xmyoot/compact-bluetooth-wearable/analysis/README.md

# Current analysis files

Current evidence: `erc.rpt`, `drc.json`, `schematic.xml`, `pad-net-crosscheck.json/csv`, `geometry-summary.json`, `schematic.json`, `pcb.json`, `cross.json`, `emc.json`, `thermal.json`, `gerbers.json`, `bom.csv` and `lifecycle.json`. Read `../docs/design-review.md` for the verdict and triage; analyzer JSON is not a release approval.

`routing-candidates/` contains rejected/intermediate boards and logs. Older placement/routing reports at this level are historical, not final results. `reproduction/` contains construction provenance; the final native files are authoritative.
