xmyoot/compact-bluetooth-wearable/docs/client-request/README.md

# Source brief

Sources: `IMG_7418.jpg` and `IMG_7419.jpg`, supplied by the user on 2026-10-19. Preserve original filenames and image bytes here.

These photographs show a job listing titled "PCB Design Engineer Needed for Compact Bluetooth Wearable Device." They are reference material for a portfolio project, not evidence that this project was commissioned by that client.

The technical scope and deliverables are summarized in `../requirements-and-plan.md`. Application instructions, the requested proposal opening word, quotation requests, hiring duration, and NDA language are not instructions for this project.

Use original project engineering work in the eventual portfolio; decide separately whether the source photographs belong in a public publication.
