xmyoot/compact-bluetooth-wearable/portfolio/bottom.png

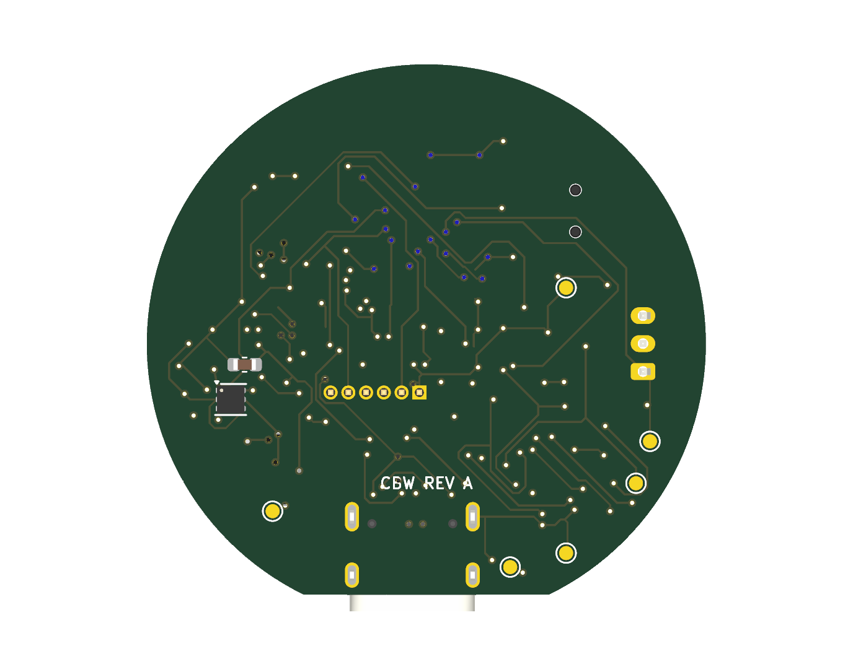
portfolio/bottom.png
