xmyoot/compact-bluetooth-wearable/portfolio/top.png

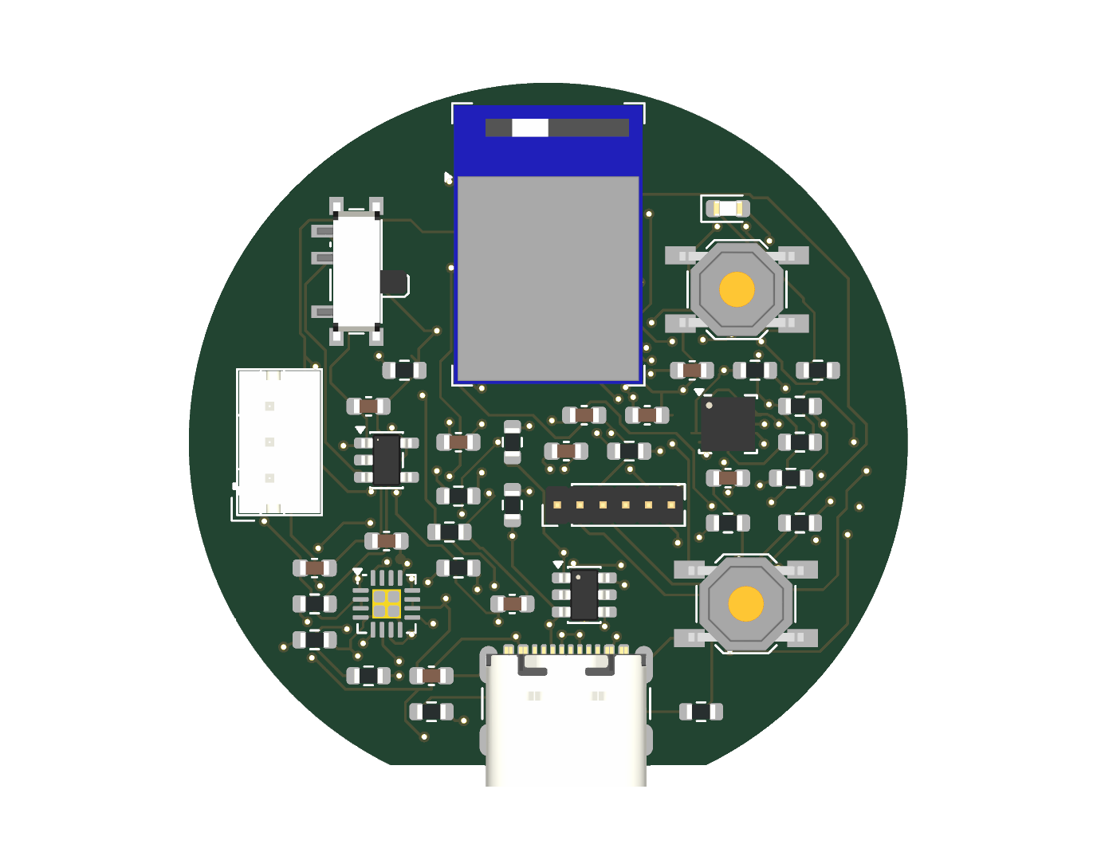
portfolio/top.png
