xmyoot/compact-bluetooth-wearable/analysis/pad-net-crosscheck.csv

Reference | Pad | Schematic net | PCB net | Result
D1 | 1 | LED_K | LED_K | match
D1 | 2 | +3V0 | +3V0 | match
J3 | 1 | +3V0 | +3V0 | match
J3 | 2 | SWDIO | SWDIO | match
J3 | 3 | SWCLK | SWCLK | match
J3 | 4 | GND | GND | match
J3 | 5 | RESET_N | RESET_N | match
J3 | 6 | GND | GND | match
SW3 | 1 | RESET_N | RESET_N | match
SW3 | 1 | RESET_N | RESET_N | match
SW3 | 2 | GND | GND | match
SW3 | 2 | GND | GND | match
R18 | 1 | BAT_SENSE | BAT_SENSE | match
R18 | 2 | GND | GND | match
C9 | 1 | +3V0 | +3V0 | match
C9 | 2 | GND | GND | match
R4 | 1 | USB_CONN_N | USB_CONN_N | match
R4 | 2 | USB_N | USB_N | match
R19 | 1 | ACC_SA0 | ACC_SA0 | match
R19 | 2 | GND | GND | match
C1 | 1 | +3V0 | +3V0 | match
C1 | 2 | GND | GND | match
J1 | A1 | GND | GND | match
J1 | A4 | VBUS | VBUS | match
J1 | A5 | CC1 | CC1 | match
J1 | A6 | USB_CONN_P | USB_CONN_P | match
J1 | A7 | USB_CONN_N | USB_CONN_N | match
J1 | A8 |  |  | match
J1 | A9 | VBUS | VBUS | match
J1 | A12 | GND | GND | match
J1 | B1 | GND | GND | match
J1 | B4 | VBUS | VBUS | match
J1 | B5 | CC2 | CC2 | match
J1 | B6 | USB_CONN_P | USB_CONN_P | match
J1 | B7 | USB_CONN_N | USB_CONN_N | match
J1 | B8 |  |  | match
J1 | B9 | VBUS | VBUS | match
J1 | B12 | GND | GND | match
J1 | SH | GND | GND | match
J1 | SH | GND | GND | match
J1 | SH | GND | GND | match
J1 | SH | GND | GND | match
C7 | 1 | VSYS | VSYS | match
C7 | 2 | GND | GND | match
U1 | 1 | GND | GND | match
U1 | 2 | GND | GND | match
U1 | 3 |  |  | match
U1 | 4 |  |  | match
U1 | 5 |  |  | match
U1 | 6 |  |  | match
U1 | 7 |  |  | match
U1 | 8 |  |  | match
U1 | 9 |  |  | match
U1 | 10 |  |  | match
U1 | 11 | BAT_SENSE | BAT_SENSE | match
U1 | 12 |  |  | match
U1 | 13 |  |  | match
U1 | 14 |  |  | match
U1 | 15 | GND | GND | match
U1 | 16 | I2C_SCL | I2C_SCL | match
U1 | 17 |  |  | match
U1 | 18 |  |  | match
U1 | 19 | I2C_SDA | I2C_SDA | match
U1 | 20 |  |  | match
U1 | 21 |  |  | match
U1 | 22 |  |  | match
U1 | 23 |  |  | match
U1 | 24 |  |  | match
U1 | 25 |  |  | match
U1 | 26 |  |  | match
U1 | 27 | ACC_INT | ACC_INT | match
U1 | 28 | +3V0 | +3V0 | match
U1 | 29 | TEMP_ALERT | TEMP_ALERT | match
U1 | 30 | +3V0 | +3V0 | match
U1 | 31 |  |  | match
U1 | 32 | VBUS | VBUS | match
U1 | 33 | GND | GND | match
U1 | 34 | USB_N | USB_N | match
U1 | 35 | USB_P | USB_P | match
U1 | 36 | LED_STATUS | LED_STATUS | match
U1 | 37 | USER_N | USER_N | match
U1 | 38 | CHG_EN1 | CHG_EN1 | match
U1 | 39 | CHG_EN2 | CHG_EN2 | match
U1 | 40 | RESET_N | RESET_N | match
U1 | 41 | CHARGE_N | CHARGE_N | match
U1 | 42 | PGOOD_N | PGOOD_N | match
U1 | 43 |  |  | match
U1 | 44 |  |  | match
U1 | 45 |  |  | match
U1 | 46 |  |  | match
U1 | 47 |  |  | match
U1 | 48 |  |  | match
U1 | 49 |  |  | match
U1 | 50 |  |  | match
U1 | 51 | SWDIO | SWDIO | match
U1 | 52 |  |  | match
U1 | 53 | SWCLK | SWCLK | match
U1 | 54 |  |  | match
U1 | 55 | GND | GND | match
U1 | 56 |  |  | match
U1 | 57 |  |  | match
U1 | 58 |  |  | match
U1 | 59 |  |  | match
U1 | 60 |  |  | match
U1 | 61 |  |  | match
R17 | 1 | VBAT | VBAT | match
R17 | 2 | BAT_SENSE | BAT_SENSE | match
R3 | 1 | USB_CONN_P | USB_CONN_P | match
R3 | 2 | USB_P | USB_P | match
R12 | 1 | I2C_SDA | I2C_SDA | match
R12 | 2 | +3V0 | +3V0 | match
J2 | 1 | VBAT | VBAT | match
J2 | 2 | BAT_NTC | BAT_NTC | match
J2 | 3 | GND | GND | match
R1 | 1 | CC1 | CC1 | match
R1 | 2 | GND | GND | match
R16 | 1 | LED_K | LED_K | match
R16 | 2 | LED_STATUS | LED_STATUS | match
R15 | 1 | RESET_N | RESET_N | match
R15 | 2 | +3V0 | +3V0 | match
R10 | 1 | CHARGE_N | CHARGE_N | match
R10 | 2 | +3V0 | +3V0 | match
C6 | 1 | VSYS | VSYS | match
C6 | 2 | GND | GND | match
D2 | 1 | USB_CONN_P | USB_CONN_P | match
D2 | 2 | GND | GND | match
D2 | 3 | USB_CONN_N | USB_CONN_N | match
D2 | 4 | USB_CONN_N | USB_CONN_N | match
D2 | 5 | VBUS | VBUS | match
D2 | 6 | USB_CONN_P | USB_CONN_P | match
R5 | 1 | ISET | ISET | match
R5 | 2 | GND | GND | match
R6 | 1 | ILIM | ILIM | match
R6 | 2 | GND | GND | match
R8 | 1 | CHG_EN2 | CHG_EN2 | match
R8 | 2 | GND | GND | match
C2 | 1 | +3V0 | +3V0 | match
C2 | 2 | GND | GND | match
R7 | 1 | CHG_EN1 | CHG_EN1 | match
R7 | 2 | GND | GND | match
U3 | 1 | VSYS | VSYS | match
U3 | 2 | GND | GND | match
U3 | 3 | POWER_EN | POWER_EN | match
U3 | 4 |  |  | match
U3 | 5 | +3V0 | +3V0 | match
U2 | 1 | BAT_NTC | BAT_NTC | match
U2 | 2 | VBAT | VBAT | match
U2 | 3 | VBAT | VBAT | match
U2 | 4 | GND | GND | match
U2 | 5 | CHG_EN2 | CHG_EN2 | match
U2 | 6 | CHG_EN1 | CHG_EN1 | match
U2 | 7 | PGOOD_N | PGOOD_N | match
U2 | 8 | GND | GND | match
U2 | 9 | CHARGE_N | CHARGE_N | match
U2 | 10 | VSYS | VSYS | match
U2 | 11 | VSYS | VSYS | match
U2 | 12 | ILIM | ILIM | match
U2 | 13 | VBUS | VBUS | match
U2 | 14 |  |  | match
U2 | 15 |  |  | match
U2 | 16 | ISET | ISET | match
U2 | 17 | GND | GND | match
C8 | 1 | +3V0 | +3V0 | match
C8 | 2 | GND | GND | match
R2 | 1 | CC2 | CC2 | match
R2 | 2 | GND | GND | match
U4 | 1 | +3V0 | +3V0 | match
U4 | 2 |  |  | match
U4 | 3 |  |  | match
U4 | 4 | I2C_SCL | I2C_SCL | match
U4 | 5 | GND | GND | match
U4 | 6 | I2C_SDA | I2C_SDA | match
U4 | 7 | ACC_SA0 | ACC_SA0 | match
U4 | 8 | +3V0 | +3V0 | match
U4 | 9 |  |  | match
U4 | 10 | GND | GND | match
U4 | 11 | ACC_INT | ACC_INT | match
U4 | 12 | GND | GND | match
U4 | 13 | GND | GND | match
U4 | 14 | +3V0 | +3V0 | match
U4 | 15 | GND | GND | match
U4 | 16 | GND | GND | match
C4 | 1 | VBUS | VBUS | match
C4 | 2 | GND | GND | match
R11 | 1 | I2C_SCL | I2C_SCL | match
R11 | 2 | +3V0 | +3V0 | match
SW1 | 1 | VSYS | VSYS | match
SW1 | 2 | POWER_EN | POWER_EN | match
SW1 | 3 | GND | GND | match
SW2 | 1 | USER_N | USER_N | match
SW2 | 1 | USER_N | USER_N | match
SW2 | 2 | GND | GND | match
SW2 | 2 | GND | GND | match
R14 | 1 | USER_N | USER_N | match
R14 | 2 | +3V0 | +3V0 | match
C5 | 1 | VBAT | VBAT | match
C5 | 2 | GND | GND | match
R13 | 1 | TEMP_ALERT | TEMP_ALERT | match
R13 | 2 | +3V0 | +3V0 | match
R9 | 1 | PGOOD_N | PGOOD_N | match
R9 | 2 | +3V0 | +3V0 | match
C3 | 1 | VBUS | VBUS | match
C3 | 2 | GND | GND | match
C10 | 1 | +3V0 | +3V0 | match
C10 | 2 | GND | GND | match
C12 | 1 | BAT_SENSE | BAT_SENSE | match
C12 | 2 | GND | GND | match
TP1 | 1 | GND | GND | match
TP2 | 1 | VBUS | VBUS | match
TP3 | 1 | VBAT | VBAT | match
C11 | 1 | +3V0 | +3V0 | match
C11 | 2 | GND | GND | match
TP6 | 1 | ACC_INT | ACC_INT | match
TP5 | 1 | +3V0 | +3V0 | match
U5 | 1 | I2C_SCL | I2C_SCL | match
U5 | 2 | GND | GND | match
U5 | 3 | TEMP_ALERT | TEMP_ALERT | match
U5 | 4 | GND | GND | match
U5 | 5 | +3V0 | +3V0 | match
U5 | 6 | I2C_SDA | I2C_SDA | match
U5 | 7 |  |  | match
TP4 | 1 | VSYS | VSYS | match
