xmyoot/compact-bluetooth-wearable/manufacturing/engineering-preview-NOT-FOR-FAB/board-preview.step

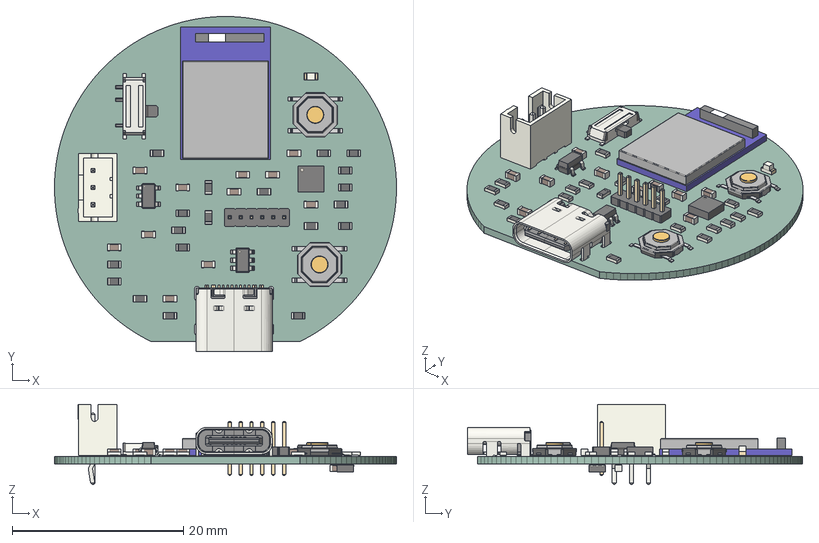
[picture p5: CAD file, 2026-10-21]
manufacturing/engineering-preview-NOT-FOR-FAB/board-preview.step
40.0 x 39.2 x 9.40 mm
LED_0603_1608Metric
PinHeader_1x06_P127mm_Vertical
SW_SPST_TL3342 x 2
R_0603_1608Metric x 19
C_0603_1608Metric x 12
USB_C_Receptacle_16P_TopMnt_Horizontal_GCT_USB4105-xx-A
Raytac_MDBT50Q
JST_B3B_PH_K
SOT-23-6
SOT-23-5
LGA_16_3x3mm_P05mm_LayoutBorder3x5y
Fusion_sp
WSON_6_1EP_2x2mm_P065mm_EP1x16mm
Compact-Bluetooth-Wearable_PCB
