xmyoot/compact-bluetooth-wearable/analysis/schematic.pdf

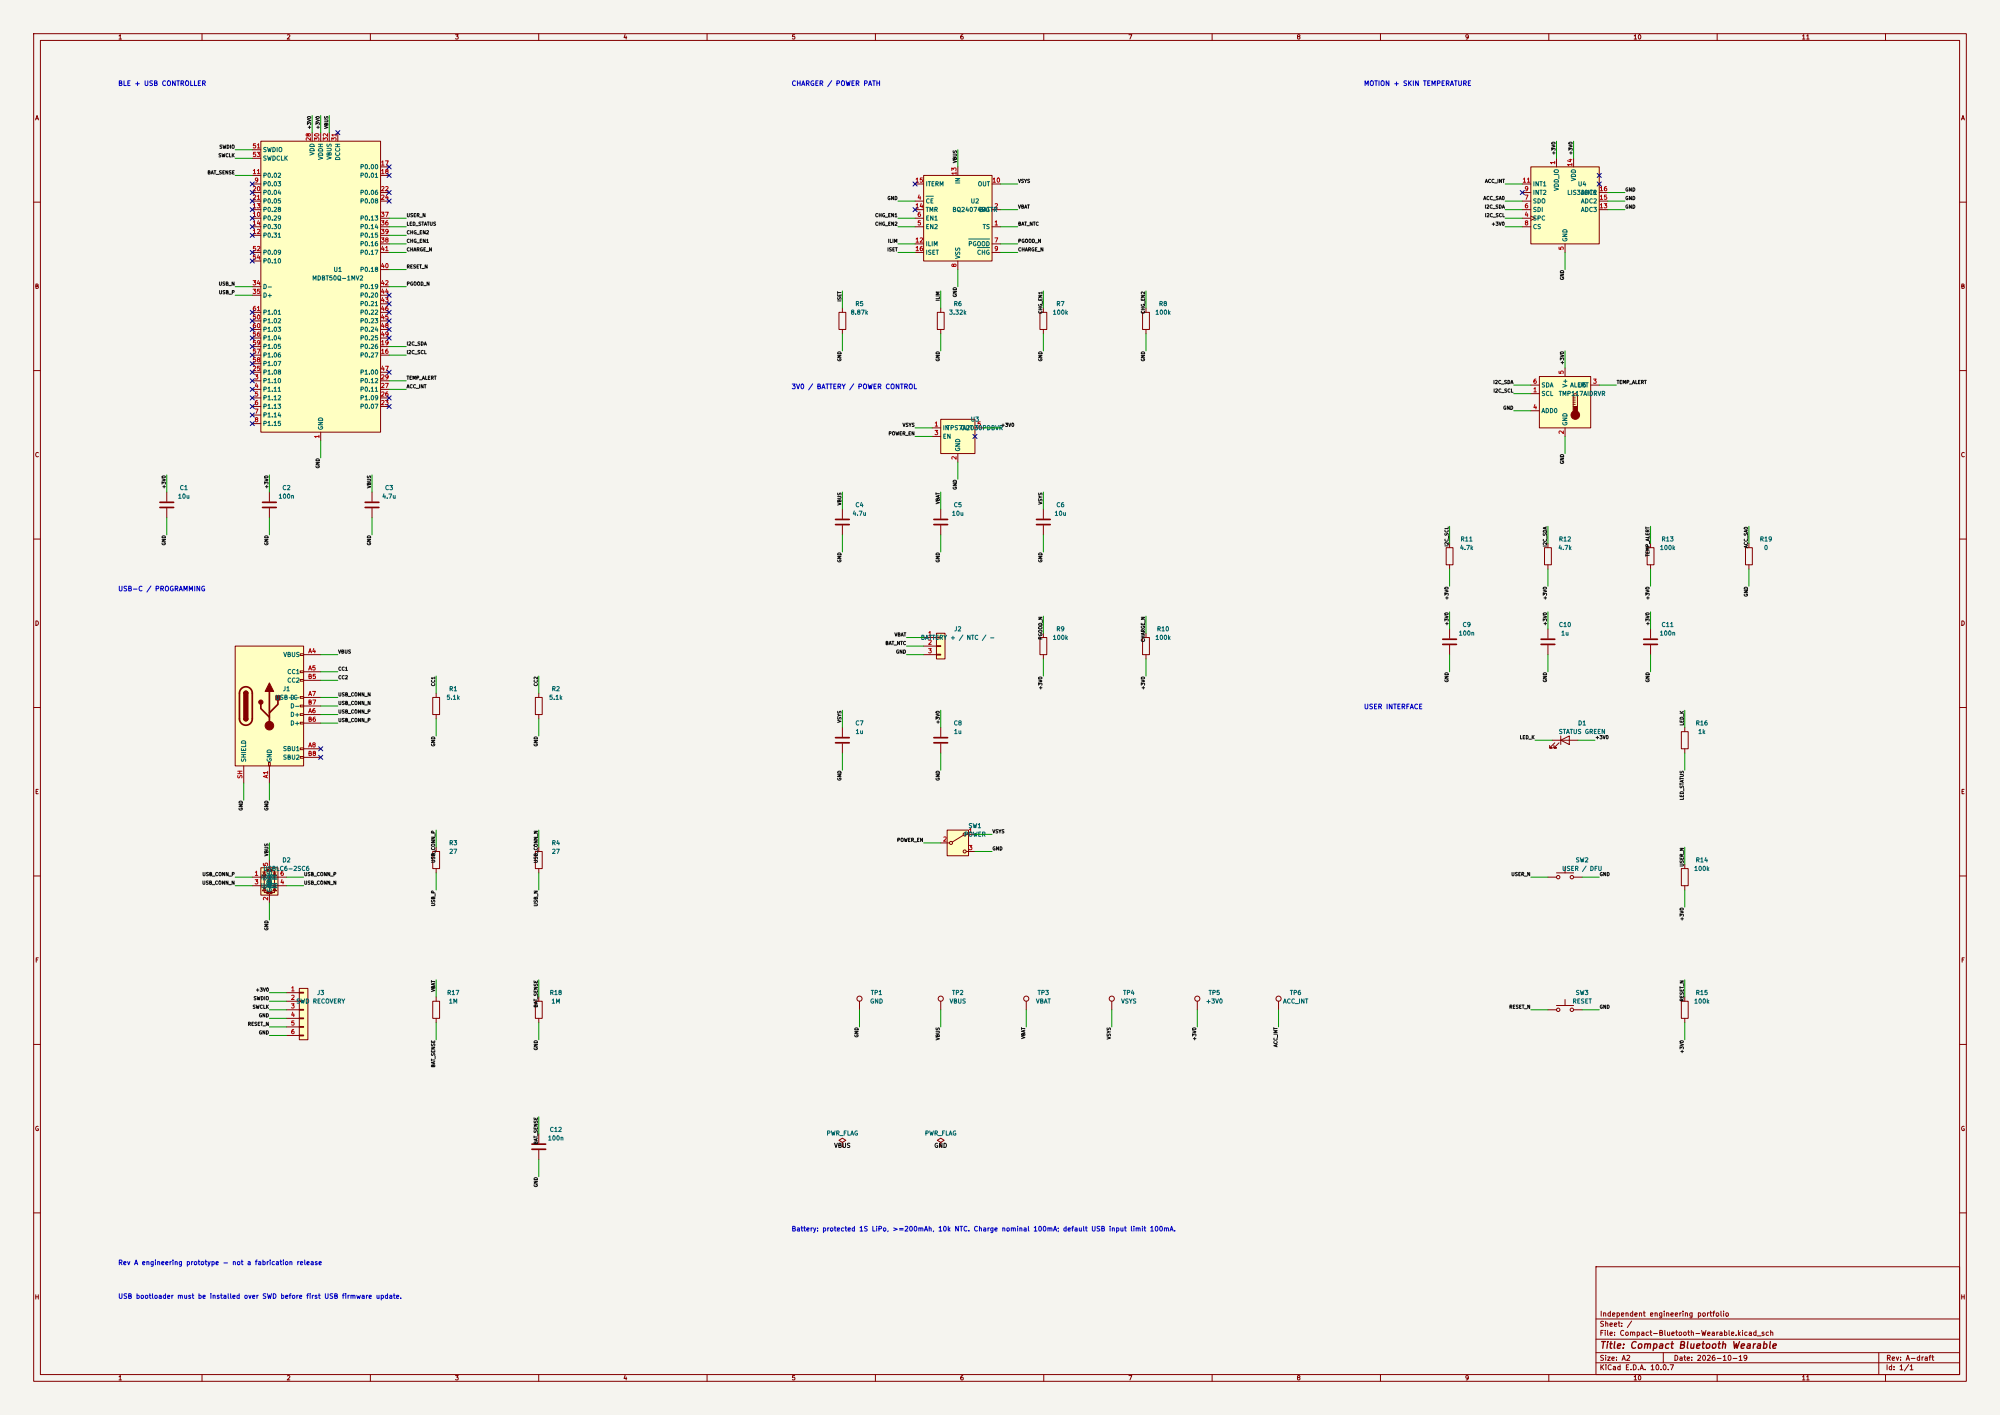
[picture p6: page 1]

MOTION + SKIN TEMPERATURE USB-C / PROGRAMMING

3V0 / BATTERY / POWER CONTROL CHARGER / POWER PATH

Battery: protected 1S LiPo, >=200mAh, 10k NTC. Charge nominal 100mA; default USB input limit 100mA.

Rev A engineering prototype - not a fabrication release USB bootloader must be installed over SWD before first USB firmware update.

Sheet: /
File: Compact-Bluetooth-Wearable.kicad_sch
Title: Compact Bluetooth Wearable

Size: A2 | Rev: A-draft
KiCad E.D.A. 10.0.7 | Id: 1/1
