xmyoot/compact-bluetooth-wearable/manufacturing/engineering-preview-NOT-FOR-FAB/assembly-bottom.pdf

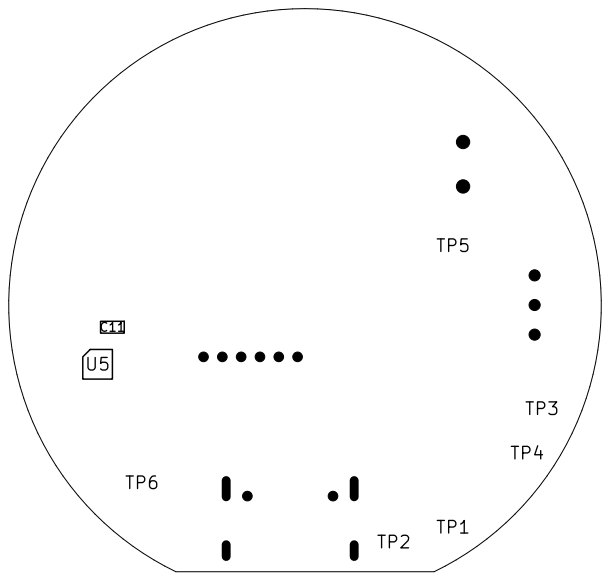
[picture p7: page 1]
