xmyoot/compact-bluetooth-wearable/manufacturing/engineering-preview-NOT-FOR-FAB/assembly-top.pdf

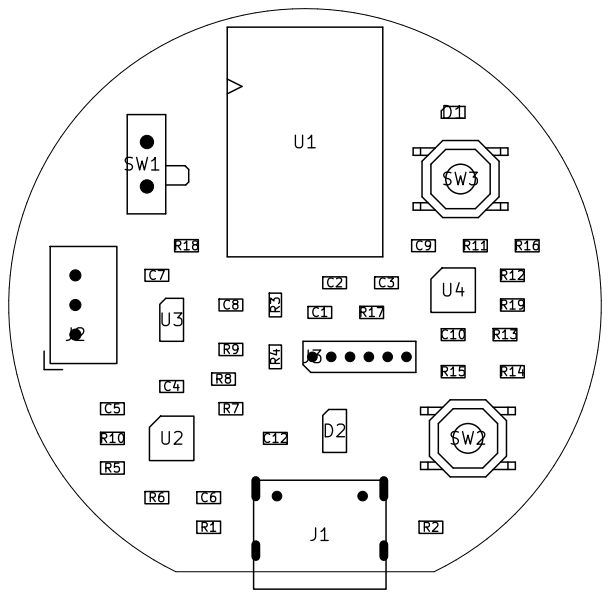
[picture p8: page 1]
