xmyoot/compact-bluetooth-wearable/hardware/Compact-Bluetooth-Wearable.kicad_pcb

## KiCad design hardware/Compact-Bluetooth-Wearable.kicad_pcb (2026-10-21)

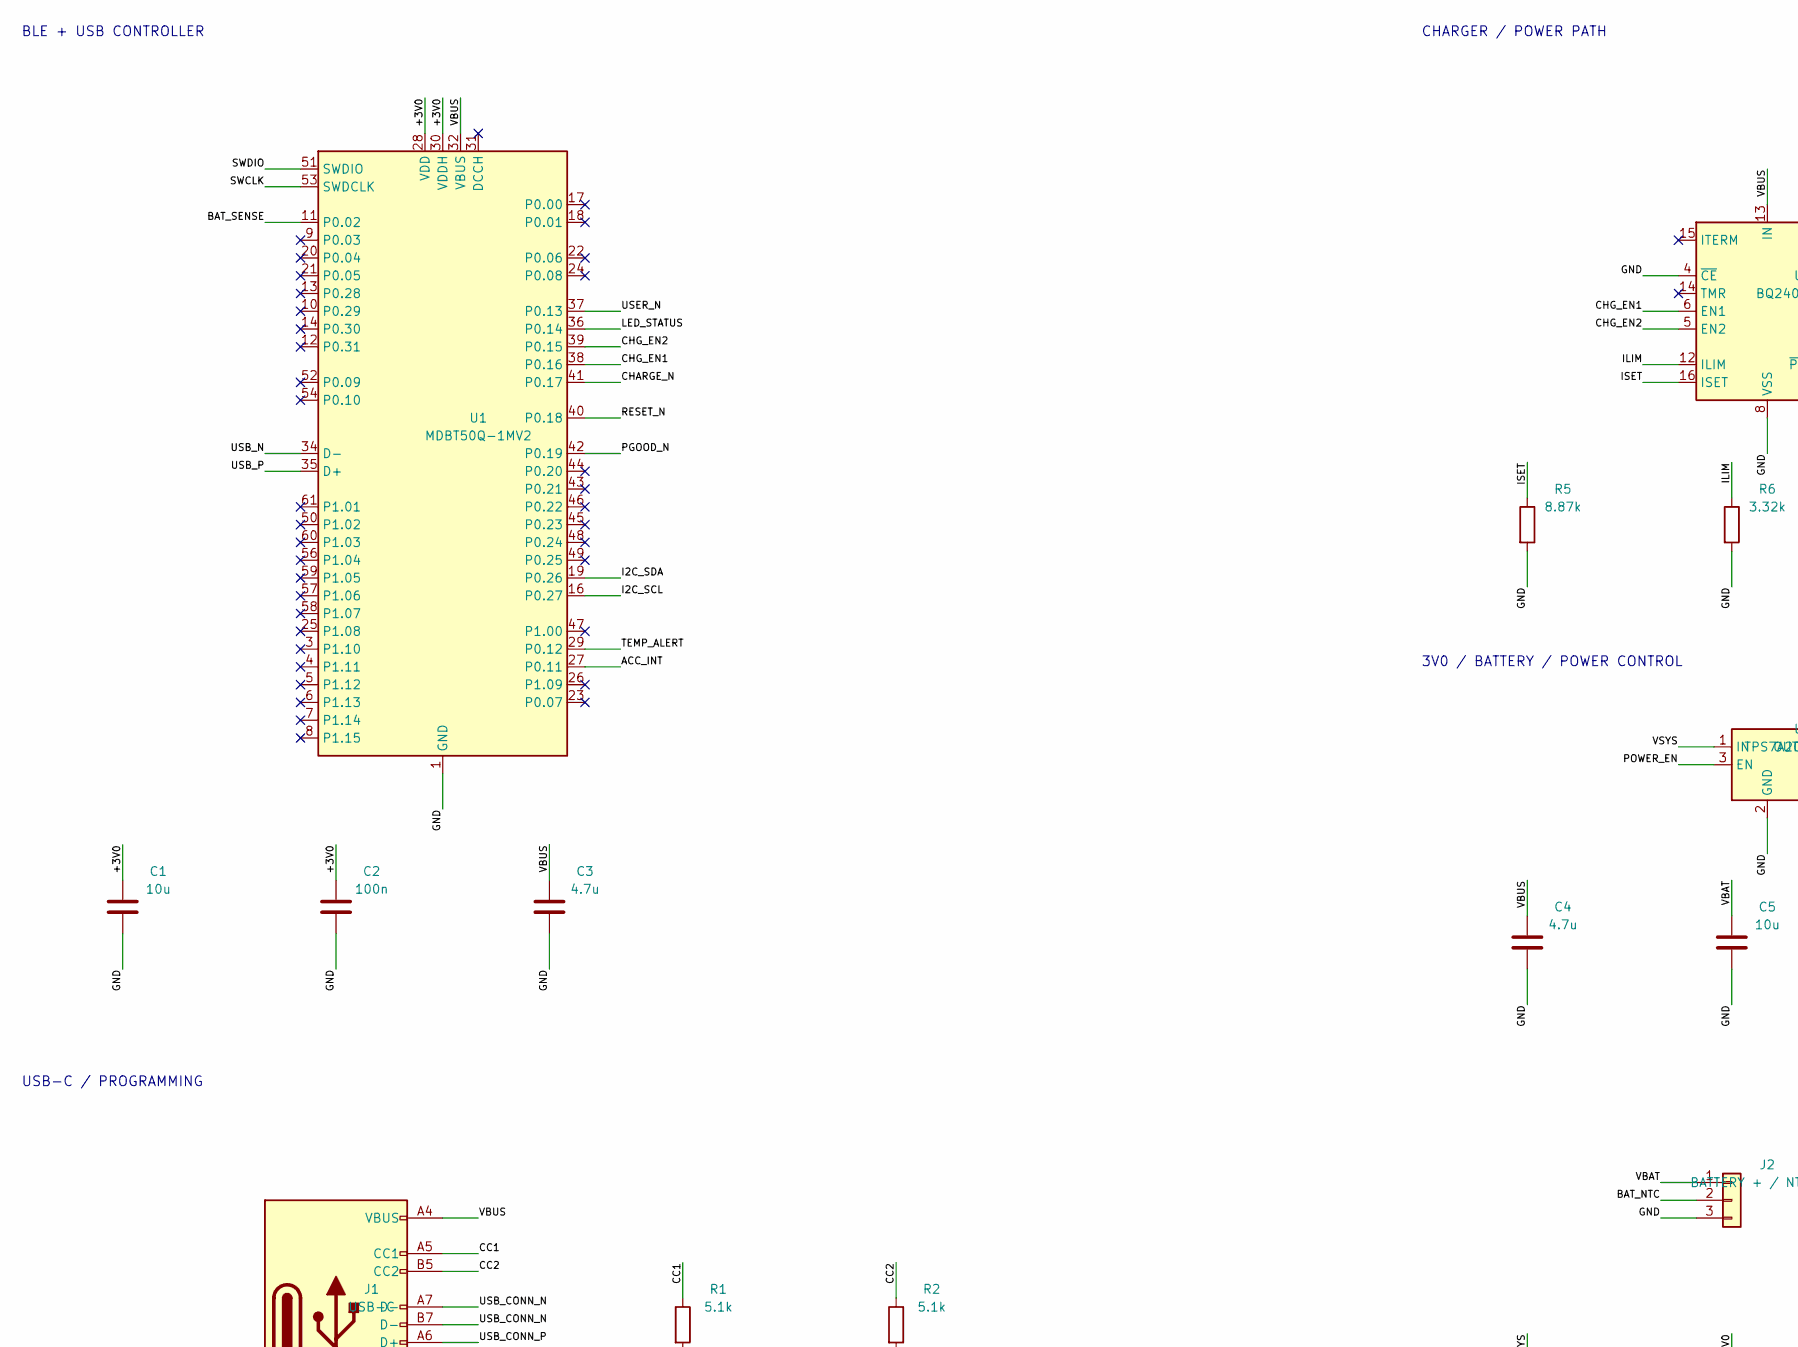
[picture p9: schematic Compact-Bluetooth-Wearable.kicad_sch, Compact Bluetooth Wearable, part in row 1, column 1]

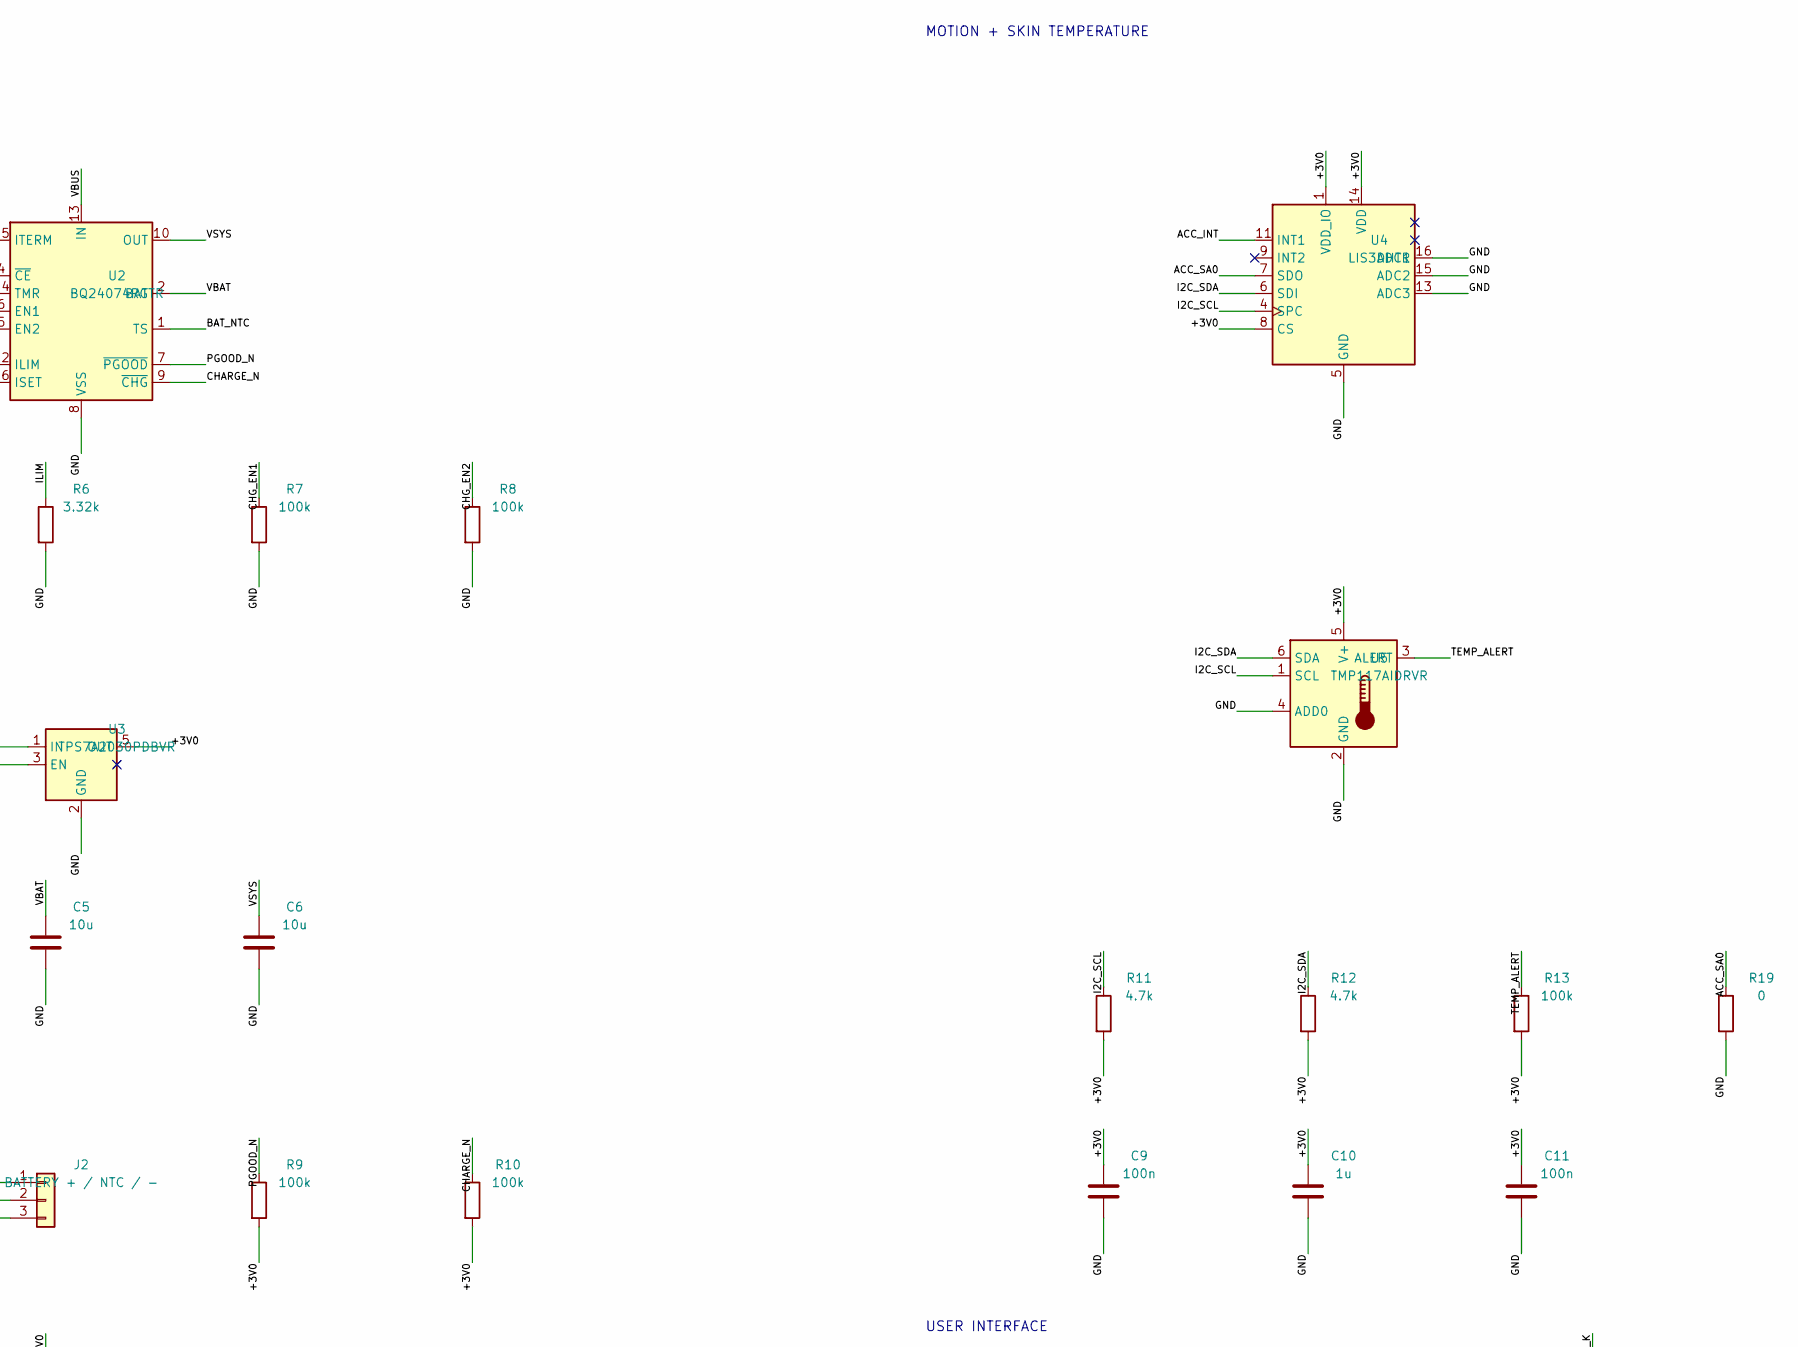
[picture p10: schematic Compact-Bluetooth-Wearable.kicad_sch, Compact Bluetooth Wearable, part in row 1, column 2]

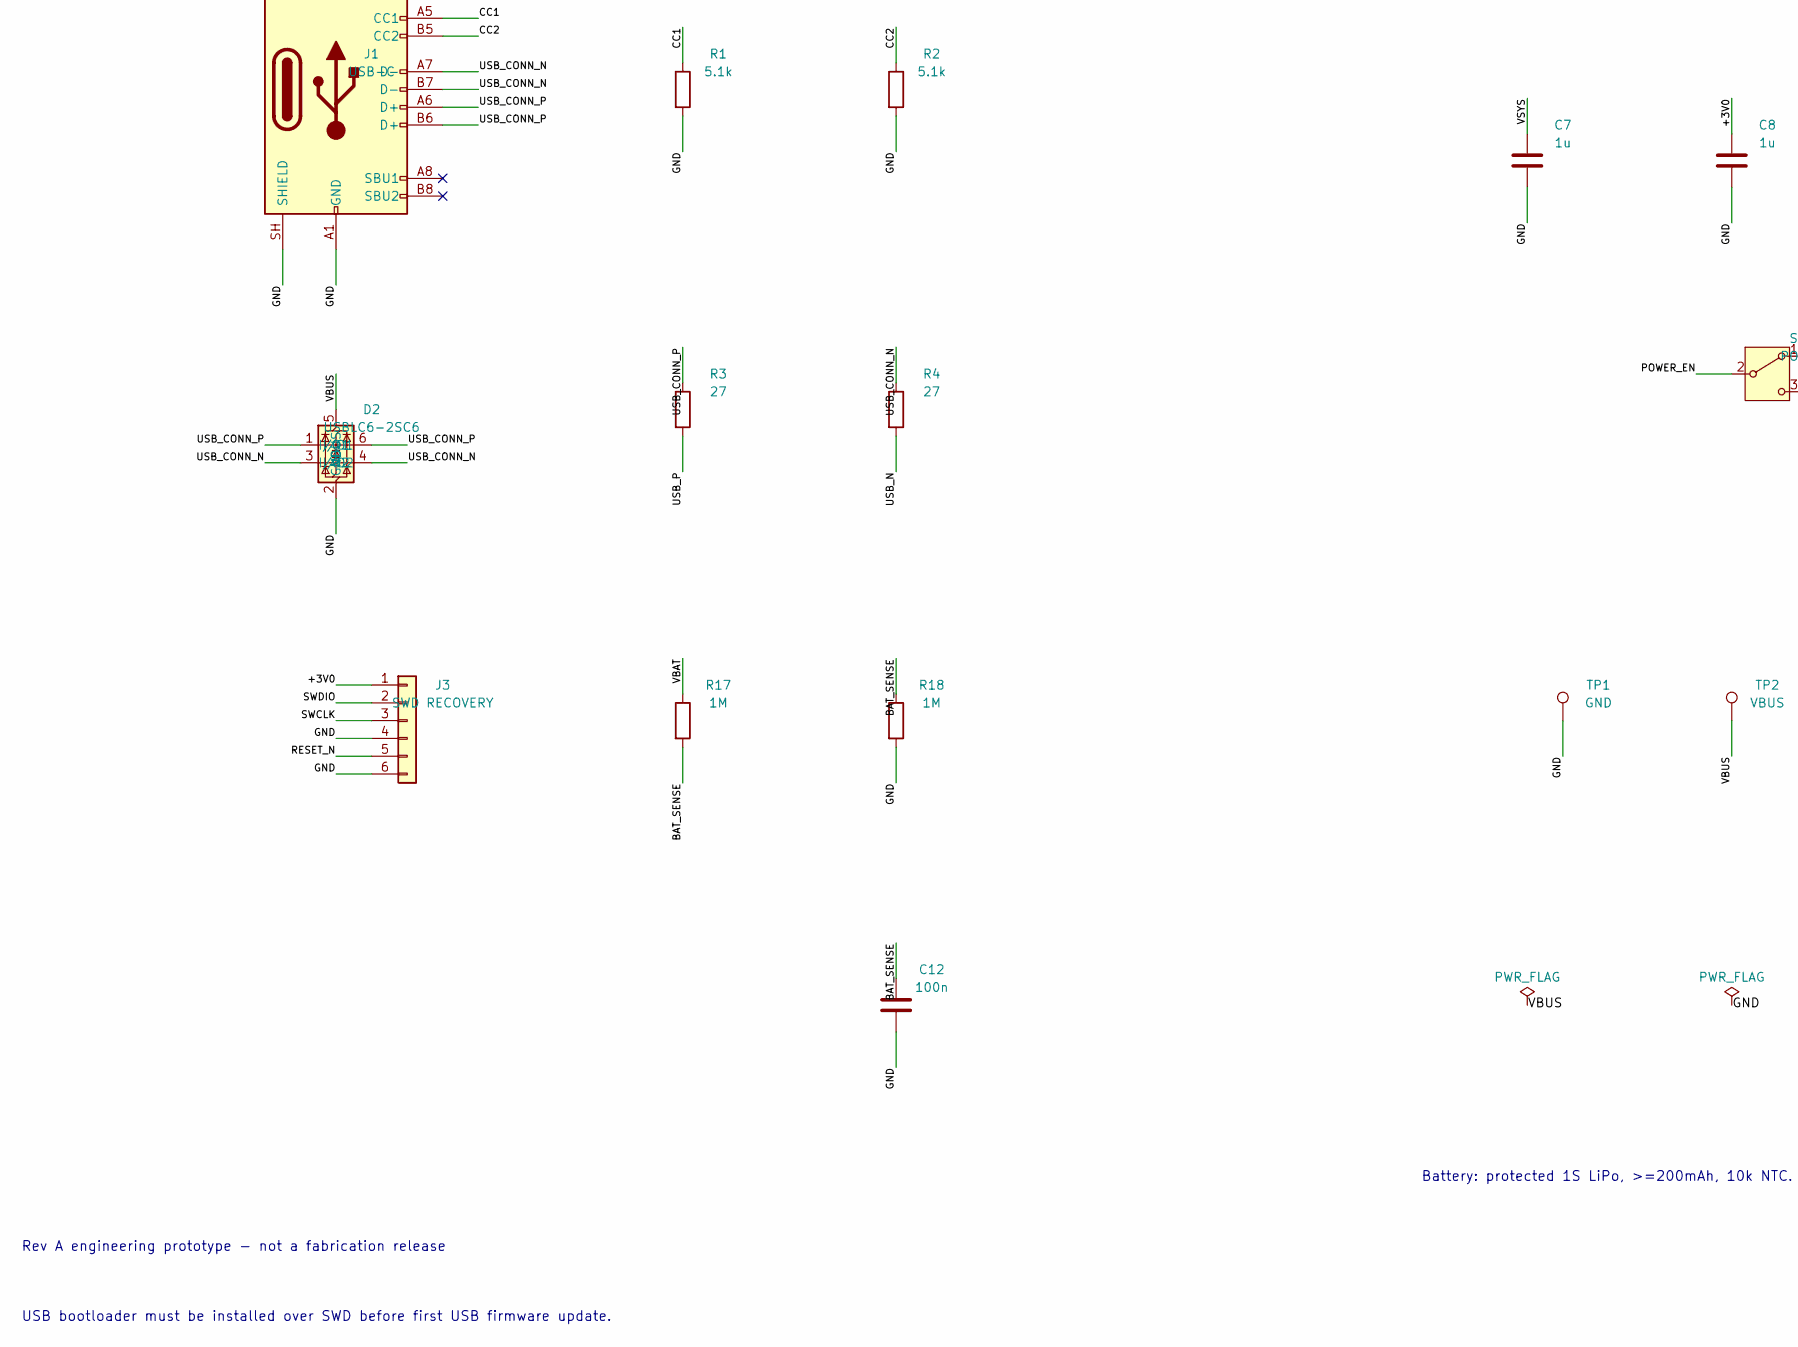
[picture p11: schematic Compact-Bluetooth-Wearable.kicad_sch, Compact Bluetooth Wearable, part in row 2, column 1]

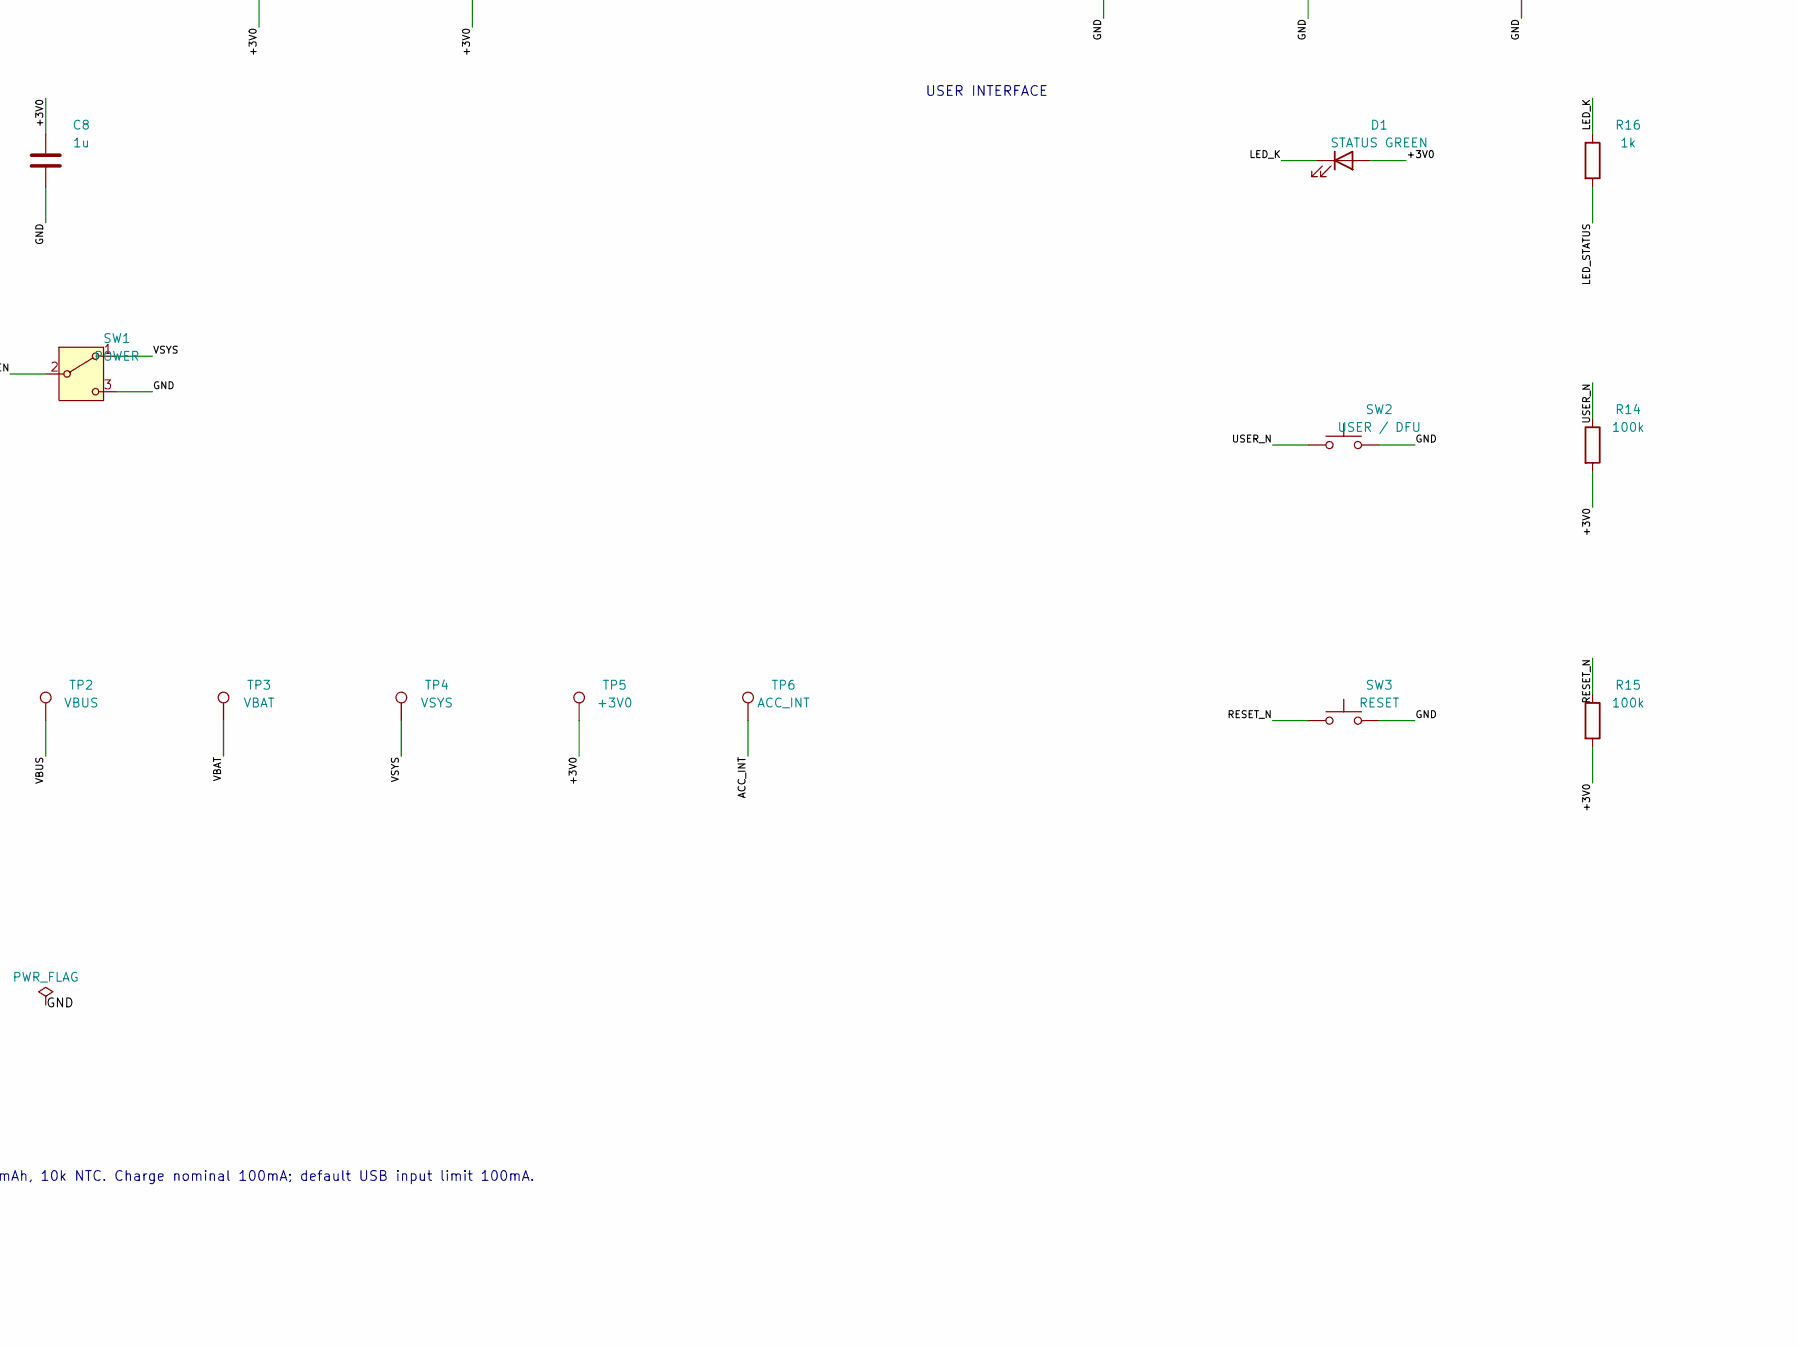
[picture p12: schematic Compact-Bluetooth-Wearable.kicad_sch, Compact Bluetooth Wearable, part in row 2, column 2]

Parts:
C1, C5, C6: 10u; C_0603_1608Metric; MPN GRM188R60J106ME47D
C2, C9, C11, C12: 100n; C_0603_1608Metric; MPN GRM188R71C104KA01D
C3, C4: 4.7u; C_0603_1608Metric; MPN GRM188R60J475KE19D
C7, C8, C10: 1u; C_0603_1608Metric; MPN GRM188R61A105KA61D
D1: STATUS GREEN; LED_0603_1608Metric; MPN LTST-C190KGKT
D2: USBLC6-2SC6; SOT-23-6; MPN USBLC6-2SC6
J1: USB-C; USB_C_Receptacle_GCT_USB4105-xx-A_16P_TopMnt_Horizontal; MPN USB4105-GF-A
J2: BATTERY + / NTC / -; JST_PH_B3B-PH-K_1x03_P2.00mm_Vertical; MPN B3B-PH-K-S(LF)(SN)
J3: SWD RECOVERY; PinHeader_1x06_P1.27mm_Vertical; MPN 20021121-00006T4LF
R1, R2: 5.1k; R_0603_1608Metric; MPN RC0603FR-075K1L
R3, R4: 27; R_0603_1608Metric; MPN RC0603FR-0727RL
R5: 8.87k; R_0603_1608Metric; MPN RC0603FR-078K87L
R6: 3.32k; R_0603_1608Metric; MPN RC0603FR-073K32L
R7, R8, R9, R10, R13, R14, R15: 100k; R_0603_1608Metric; MPN RC0603FR-07100KL
R11, R12: 4.7k; R_0603_1608Metric; MPN RC0603FR-074K7L
R16: 1k; R_0603_1608Metric; MPN RC0603FR-071KL
R17, R18: 1M; R_0603_1608Metric; MPN RC0603FR-071ML
R19: 0; R_0603_1608Metric; MPN RC0603JR-070RL
SW1: POWER; SW_SPDT_PCM12; MPN PCM12SMTR
SW2: USER / DFU; SW_SPST_TL3342; MPN TL3342F160QG
SW3: RESET; SW_SPST_TL3342; MPN TL3342F160QG
TP1: GND; TestPoint_Pad_D1.0mm
TP2: VBUS; TestPoint_Pad_D1.0mm
TP3: VBAT; TestPoint_Pad_D1.0mm
TP4: VSYS; TestPoint_Pad_D1.0mm
TP5: +3V0; TestPoint_Pad_D1.0mm
TP6: ACC_INT; TestPoint_Pad_D1.0mm
U1: MDBT50Q-1MV2; Raytac_MDBT50Q; MPN MDBT50Q-1MV2
U2: BQ24074RGTR; VQFN-16-1EP_3x3mm_P0.5mm_EP1.6x1.6mm; MPN BQ24074RGTR
U3: TPS7A2030PDBVR; SOT-23-5; MPN TPS7A2030PDBVR
U4: LIS3DHTR; LGA-16_3x3mm_P0.5mm_LayoutBorder3x5y; MPN LIS3DHTR
U5: TMP117AIDRVR; TMP117_NoPasteEP; MPN TMP117AIDRVR

Connections:
/+3V0: C1.1, C2.1, C8.1, C9.1, C10.1, C11.1, D1.2 (A), J3.1, R9.2, R10.2, R11.2, R12.2, R13.2, R14.2, R15.2, TP5.1, U1.28 (VDD), U1.30 (VDDH), U3.5 (OUT), U4.1 (VDD_IO), U4.8 (CS), U4.14 (VDD), U5.5 (V+)
/ACC_INT: TP6.1, U1.27 (P0.11), U4.11 (INT1)
/ACC_SA0: R19.1, U4.7 (SDO)
/BAT_NTC: J2.2, U2.1 (TS)
/BAT_SENSE: C12.1, R17.2, R18.1, U1.11 (P0.02)
/CC1: J1.A5 (CC1), R1.1
/CC2: J1.B5 (CC2), R2.1
/CHARGE_N: R10.1, U1.41 (P0.17), U2.9 (~CHG)
/CHG_EN1: R7.1, U1.38 (P0.16), U2.6 (EN1)
/CHG_EN2: R8.1, U1.39 (P0.15), U2.5 (EN2)
/GND: C1.2, C2.2, C3.2, C4.2, C5.2, C6.2, C7.2, C8.2, C9.2, C10.2, C11.2, C12.2, D2.2 (GND), J1.A1 (GND), J1.A12 (GND), J1.B1 (GND), J1.B12 (GND), J1.SH (SHIELD), J2.3, J3.4, J3.6, R1.2, R2.2, R5.2, R6.2, R7.2, R8.2, R18.2, R19.2, SW1.3 (C), SW2.2, SW3.2, TP1.1, U1.1 (GND), U1.2 (GND), U1.15 (GND), U1.33 (GND), U1.55 (GND), U2.4 (~CE), U2.8 (VSS), U2.17 (VSS), U3.2 (GND), U4.5 (GND), U4.10 (GND), U4.12 (GND), U4.13 (ADC3), U4.15 (ADC2), U4.16 (ADC1), U5.2 (GND), U5.4 (ADD0)
/I2C_SCL: R11.1, U1.16 (P0.27), U4.4 (SPC), U5.1 (SCL)
/I2C_SDA: R12.1, U1.19 (P0.26), U4.6 (SDI), U5.6 (SDA)
/ILIM: R6.1, U2.12 (ILIM)
/ISET: R5.1, U2.16 (ISET)
/LED_K: D1.1 (K), R16.1
/LED_STATUS: R16.2, U1.36 (P0.14)
/PGOOD_N: R9.1, U1.42 (P0.19), U2.7 (~PGOOD)
/POWER_EN: SW1.2 (B), U3.3 (EN)
/RESET_N: J3.5, R15.1, SW3.1, U1.40 (P0.18)
/SWCLK: J3.3, U1.53 (SWDCLK)
/SWDIO: J3.2, U1.51 (SWDIO)
/TEMP_ALERT: R13.1, U1.29 (P0.12), U5.3 (ALERT)
/USB_CONN_N: D2.3 (I/O2), D2.4 (I/O2), J1.A7 (D-), J1.B7 (D-), R4.1
/USB_CONN_P: D2.1 (I/O1), D2.6 (I/O1), J1.A6 (D+), J1.B6 (D+), R3.1
/USB_N: R4.2, U1.34 (D-)
/USB_P: R3.2, U1.35 (D+)
/USER_N: R14.1, SW2.1, U1.37 (P0.13)
/VBAT: C5.1, J2.1, R17.1, TP3.1, U2.2 (BAT), U2.3 (BAT)
/VBUS: C3.1, C4.1, D2.5 (VBUS), J1.A4 (VBUS), J1.A9 (VBUS), J1.B4 (VBUS), J1.B9 (VBUS), TP2.1, U1.32 (VBUS), U2.13 (IN)
/VSYS: C6.1, C7.1, SW1.1 (A), TP4.1, U2.10 (OUT), U2.11 (OUT), U3.1 (IN)

Notes on the sheet:
BLE + USB CONTROLLER
USB-C / PROGRAMMING
CHARGER / POWER PATH
3V0 / BATTERY / POWER CONTROL
MOTION + SKIN TEMPERATURE
USER INTERFACE
Rev A engineering prototype - not a fabrication release
USB bootloader must be installed over SWD before first USB firmware update.
Battery: protected 1S LiPo, >=200mAh, 10k NTC. Charge nominal 100mA; default USB input limit 100mA.

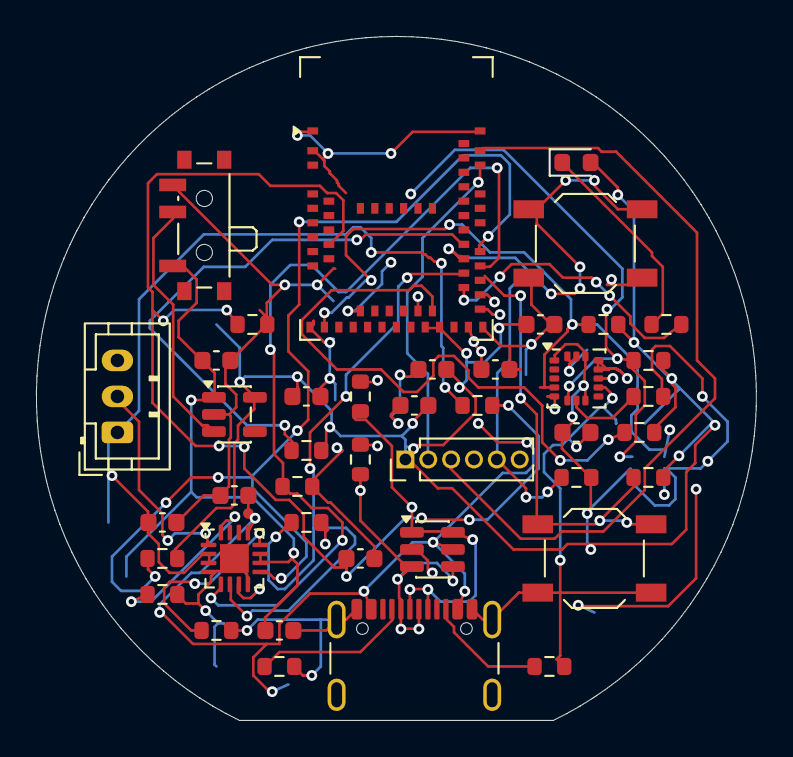
[picture p13: board Compact-Bluetooth-Wearable.kicad_pcb from above]

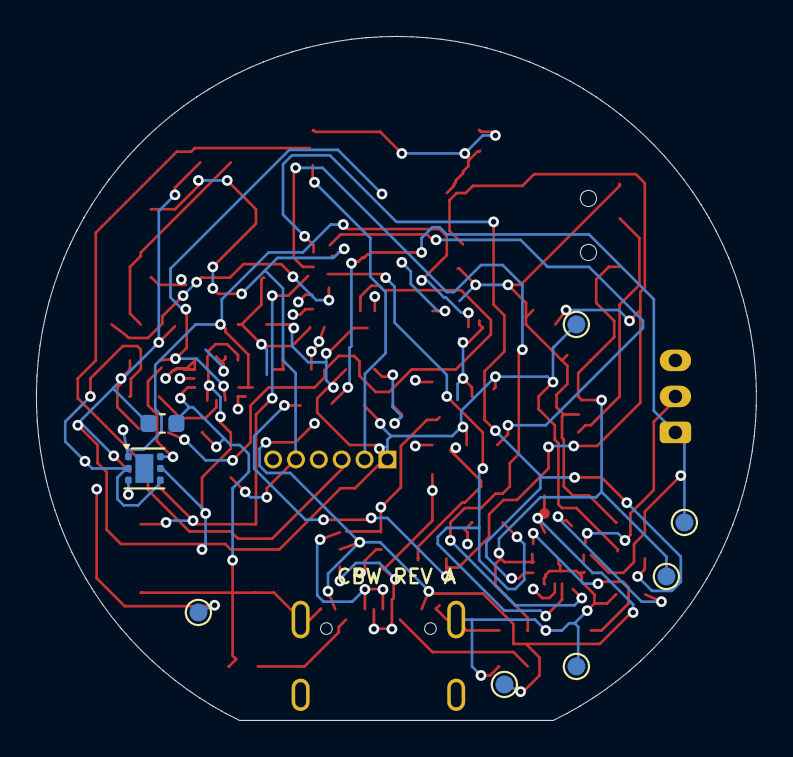
[picture p14: board Compact-Bluetooth-Wearable.kicad_pcb from below]

Board: 4 copper layers, 40.0 x 38.0 mm, 50 parts (8 on the bottom side), 31 nets.
