xmyoot/compact-bluetooth-wearable/docs/client-request/IMG_7419.jpg

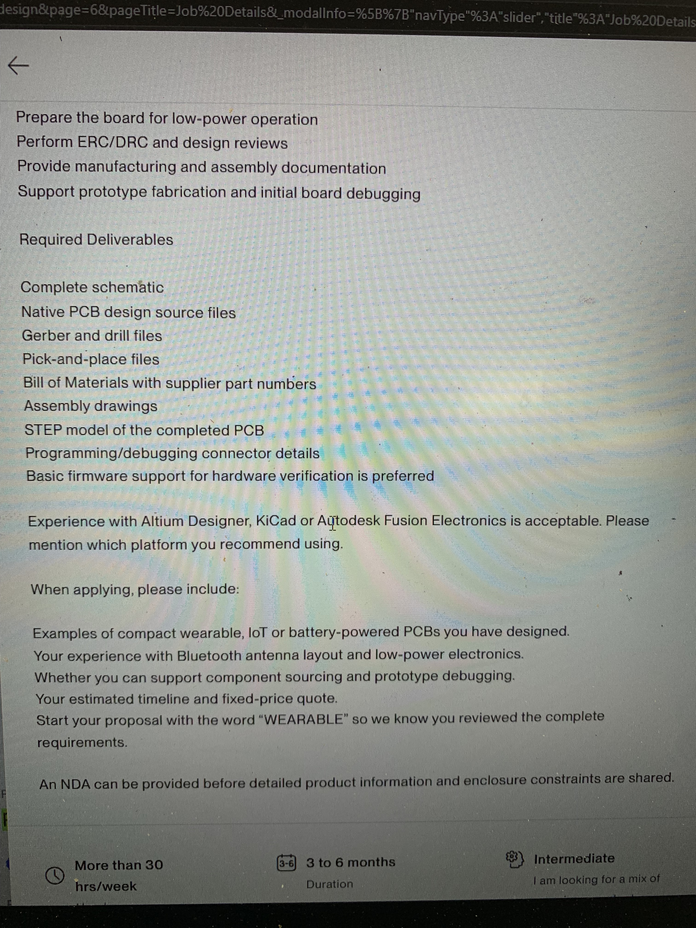
docs/client-request/IMG_7419.jpg
