xmyoot/compact-bluetooth-wearable/docs/client-request/IMG_7418.jpg

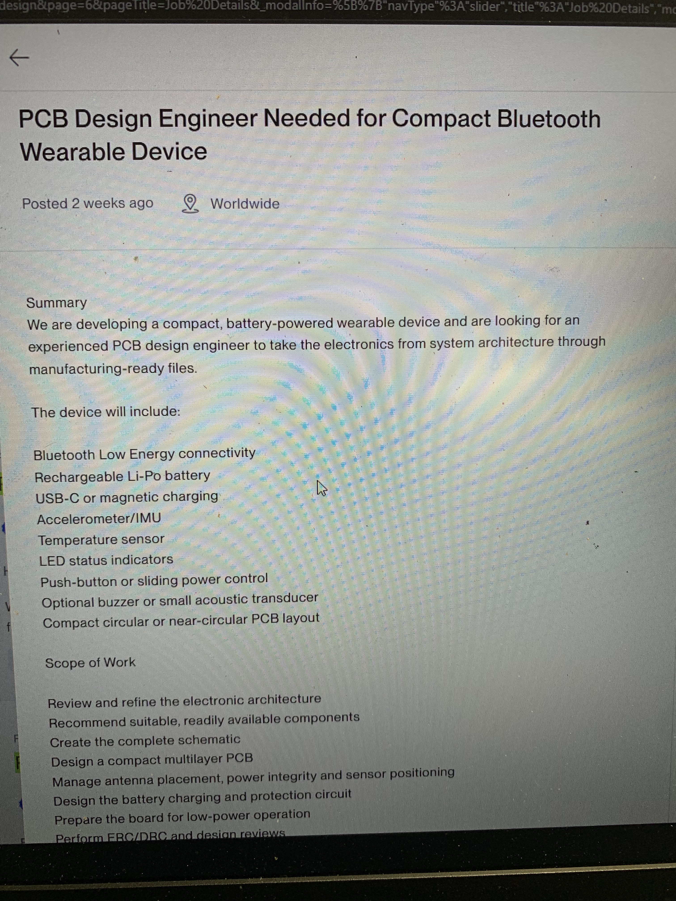
docs/client-request/IMG_7418.jpg
